zischl/ZAIR/README.md

# 🐭 ZAIR - 4WD Vacuum Micromouse

A custom 4WD vacuum micromouse built for the Sri Lanka IIT Micro Maze 3.0 competition (IEEE 16×16).

The PCB also serves as the robot's structural chassis, with cutouts for the drive wheels and a central aperture for a 1020 coreless motor suction fan.

<p align="center">
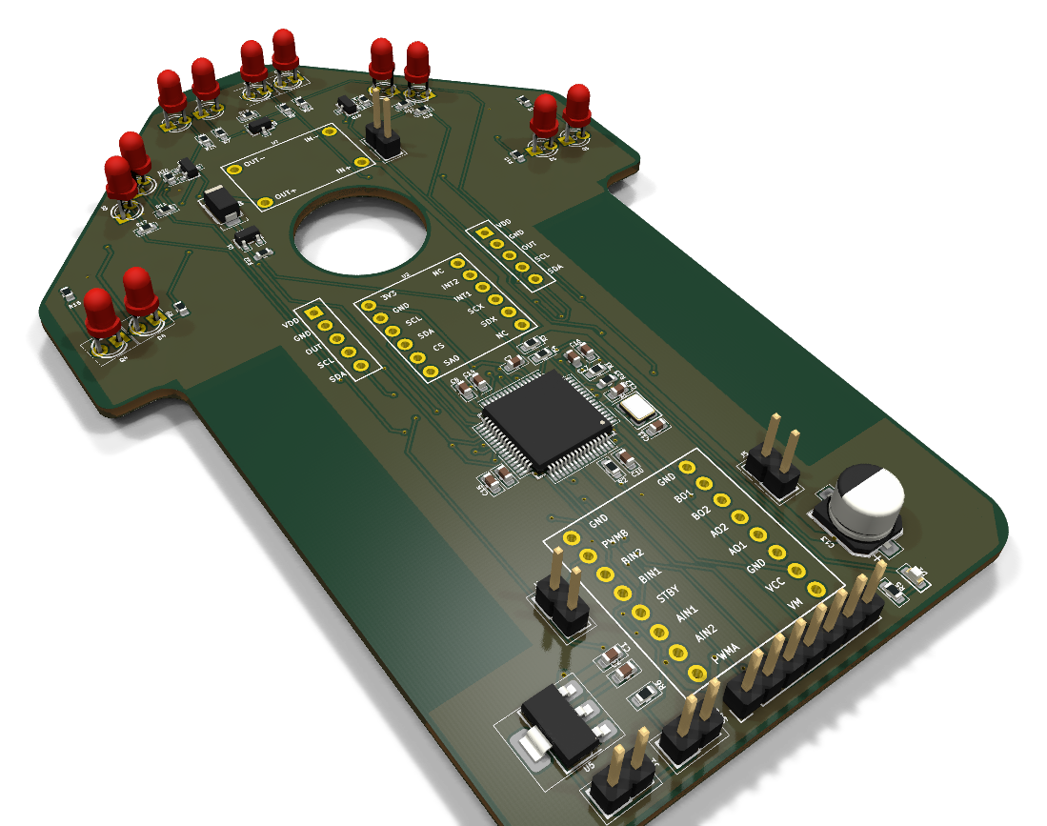
[picture p1: assets/pcb_render_isometric.png]
ZAIR PCB 3D Render
  
</p>

---

## 📸 PCB

| Top (Components) | Bottom |
| :---: | :---: |
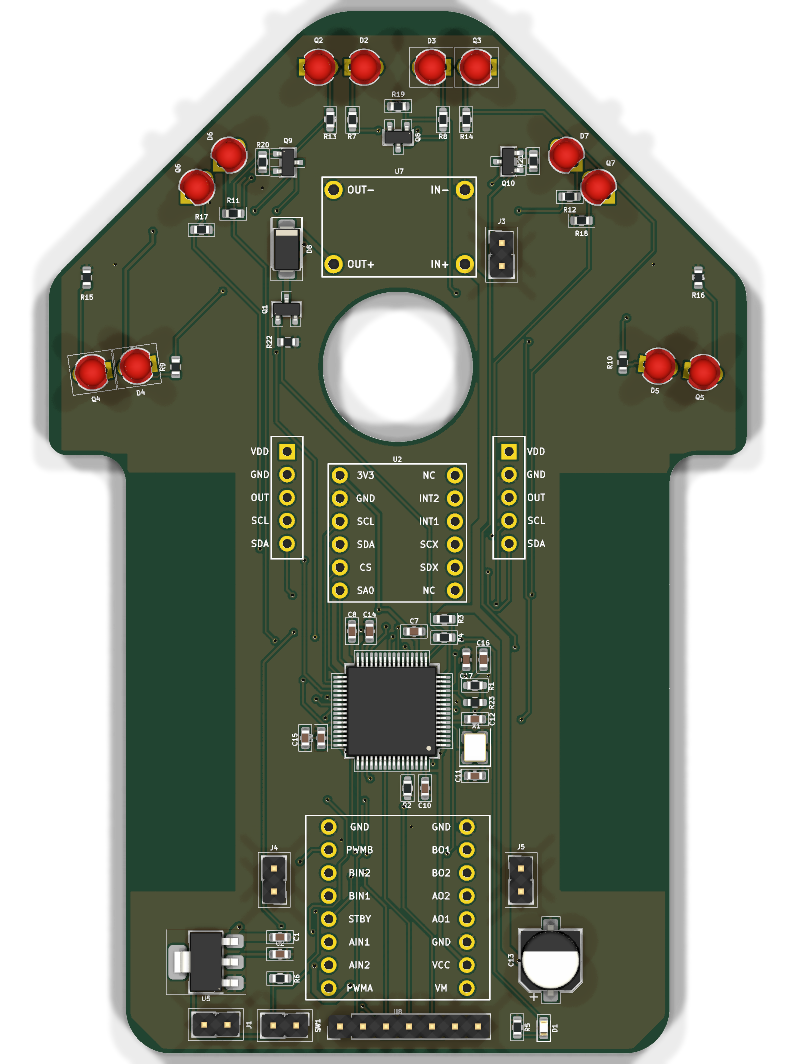
[picture p2: assets/pcb_render_top.png]
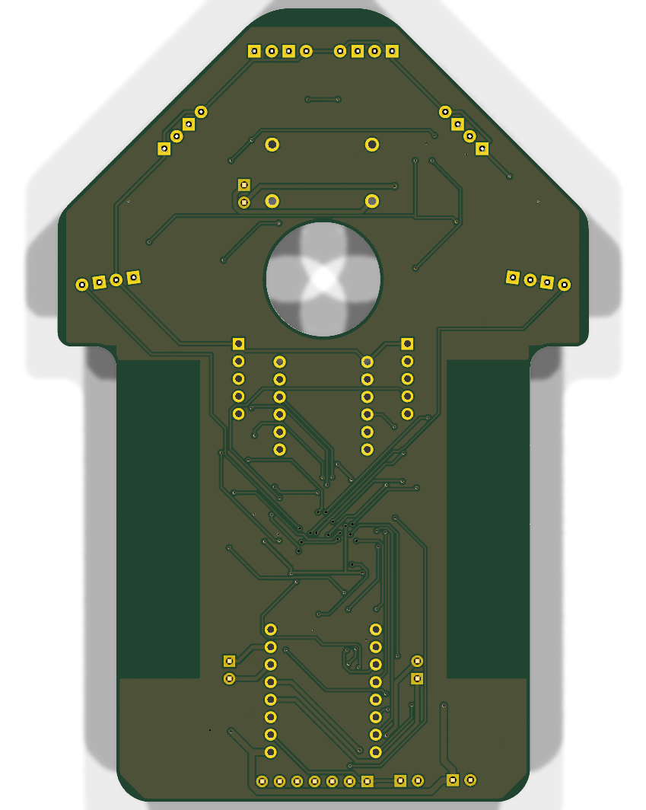
[picture p3: assets/pcb_render_bottom.png]
|  |  |

| Traces / Silkscreen | Outline & Cutouts |
| :---: | :---: |
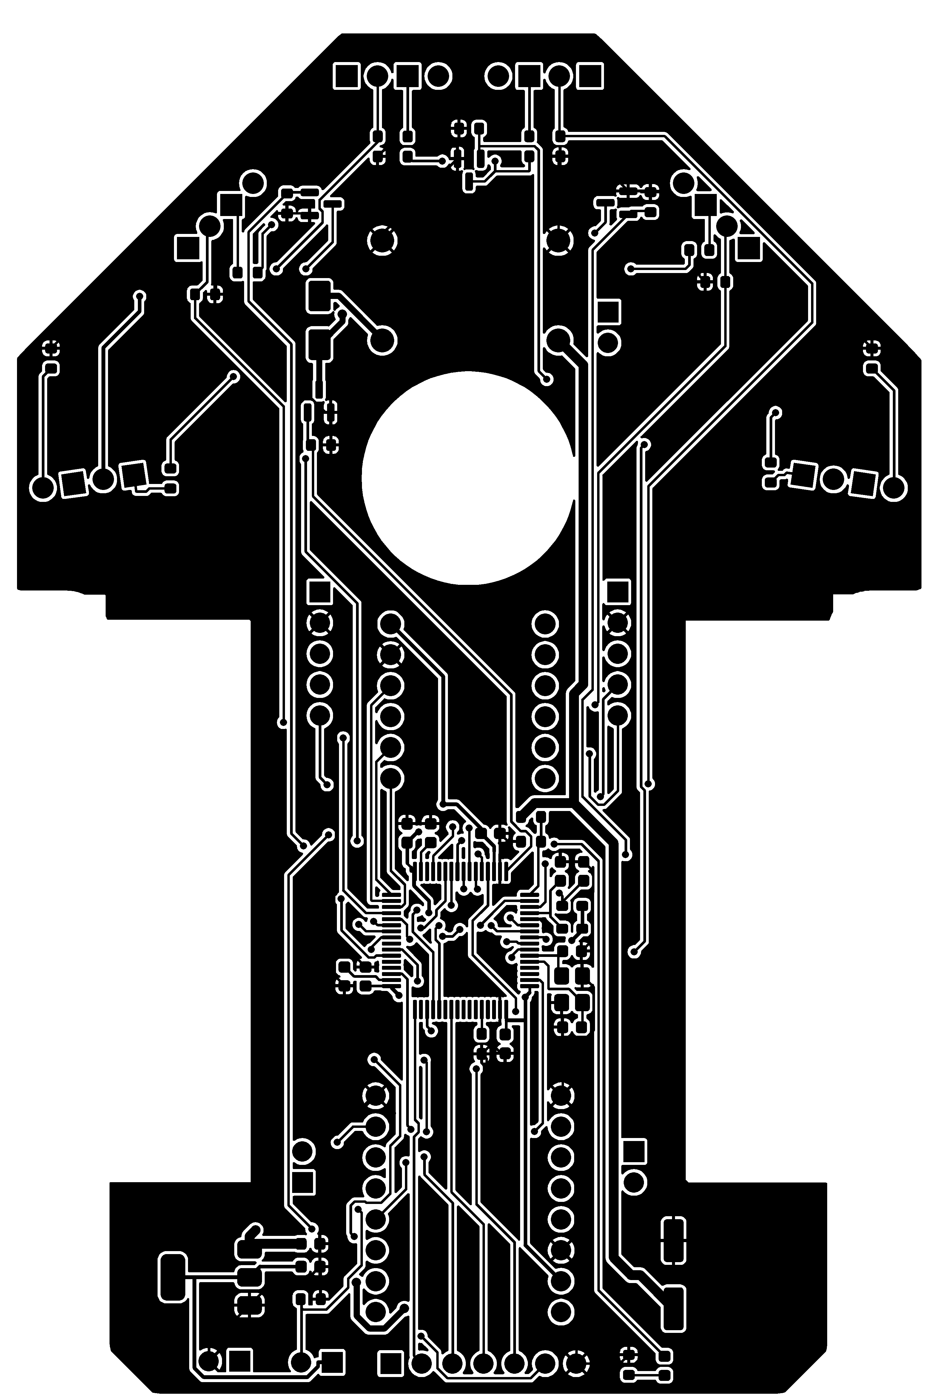
[picture p4: assets/pcb_top.png]
|  |  |

---

## ⚡ Hardware & Components

- **MCU:** STM32F405RGT6 (ARM Cortex-M4 @ 168MHz)
- **Drive Motors:** 2× Coreless 1718 motors
- **Motor Driver:** TB6612FNG breakout (red module)
- **Vacuum Fan:** Coreless 1020 motor switched by an AO3400 N-MOSFET + SS14 flyback diode
- **IMU:** LSM6DSV breakout (SPI2)
- **Encoders:** 2× MT6701 magnetic encoders (vertical 90° mounts, ABZ quadrature mode to TIM2/TIM3)
- **Sensors:** 4 active IR pairs (TEFT4300 phototransistors + SFH4545 850nm emitters, pulsed via AO3400 FETs)
- **Power:**
  - 2S LiPo (7.4V nominal)
  - MP2307 Mini360 buck converter stepped down to 3.5V for the vacuum motor
  - AMS1117-3.3 for 3.3V logic
- **Programming / Debug:** 7-pin header for SWD (`SWDIO`, `SWDCK`, `SWO`) and USART1 (`TX`, `RX`)

---

## 🛠️ PCB Specs & Files

Designed in KiCad.

- **Layers:** 2-layer FR4
- **Dimensions:** ~80mm × 115mm (1.6mm thickness, 1oz copper)
- **Silkscreen:** White

### Files

- **KiCad Project:** `hardware/schematic/ZAIR/`
- **Schematic PDF:** [`hardware/schematic/ZAIR/ZAIR_Schematic.pdf`](hardware/schematic/ZAIR/ZAIR_Schematic.pdf)
- **Gerbers:** [`hardware/schematic/ZAIR/gerbers/`](hardware/schematic/ZAIR/gerbers/)
- **BOM:** [`hardware/schematic/ZAIR/ZAIR.csv`](hardware/schematic/ZAIR/ZAIR.csv)

---

## ⚙️ Drivetrain CAD

Designed in Onshape. A 3-gear direct-drive setup where the central Coreless 1718 motor pinion meshes simultaneously with both geared wheels.

| 3-Gear Mesh | Drivetrain Assembly |
| :---: | :---: |
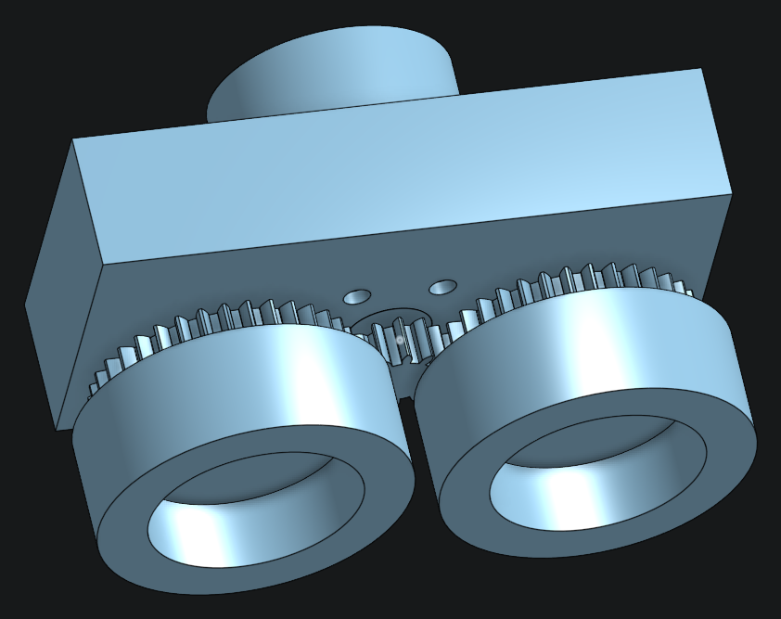
[picture p5: assets/drivetrain_mesh.png]
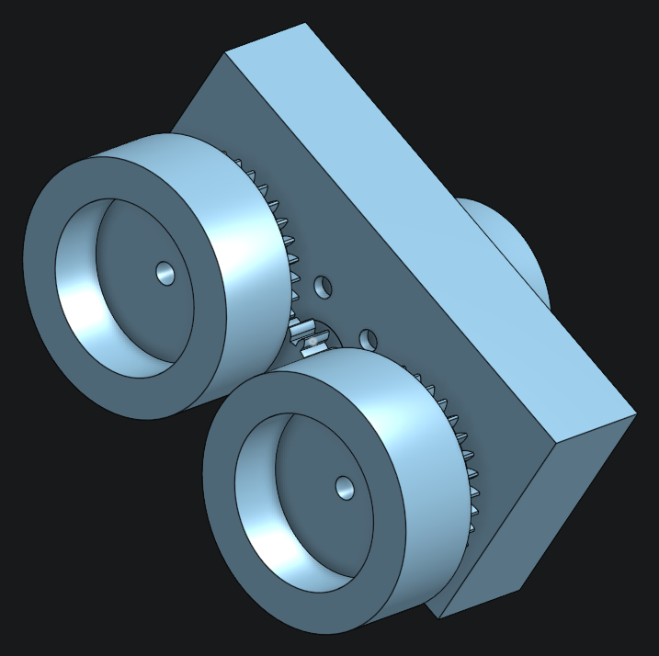
[picture p6: assets/drivetrain_assembly.png]
|  |  |

### STEP Models (`hardware/cad/`)

- **Motor:** Coreless 1718 ([`hardware/cad/motor_1718.step`](hardware/cad/motor_1718.step))
- **Wheel:** 22mm Geared Wheel ([`hardware/cad/geared_wheel.step`](hardware/cad/geared_wheel.step))
- **Mount:** Drivetrain motor mount bracket ([`hardware/cad/drivetrain_mount.step`](hardware/cad/drivetrain_mount.step))
