zischl/ZAIR/assets/pcb_bottom.png

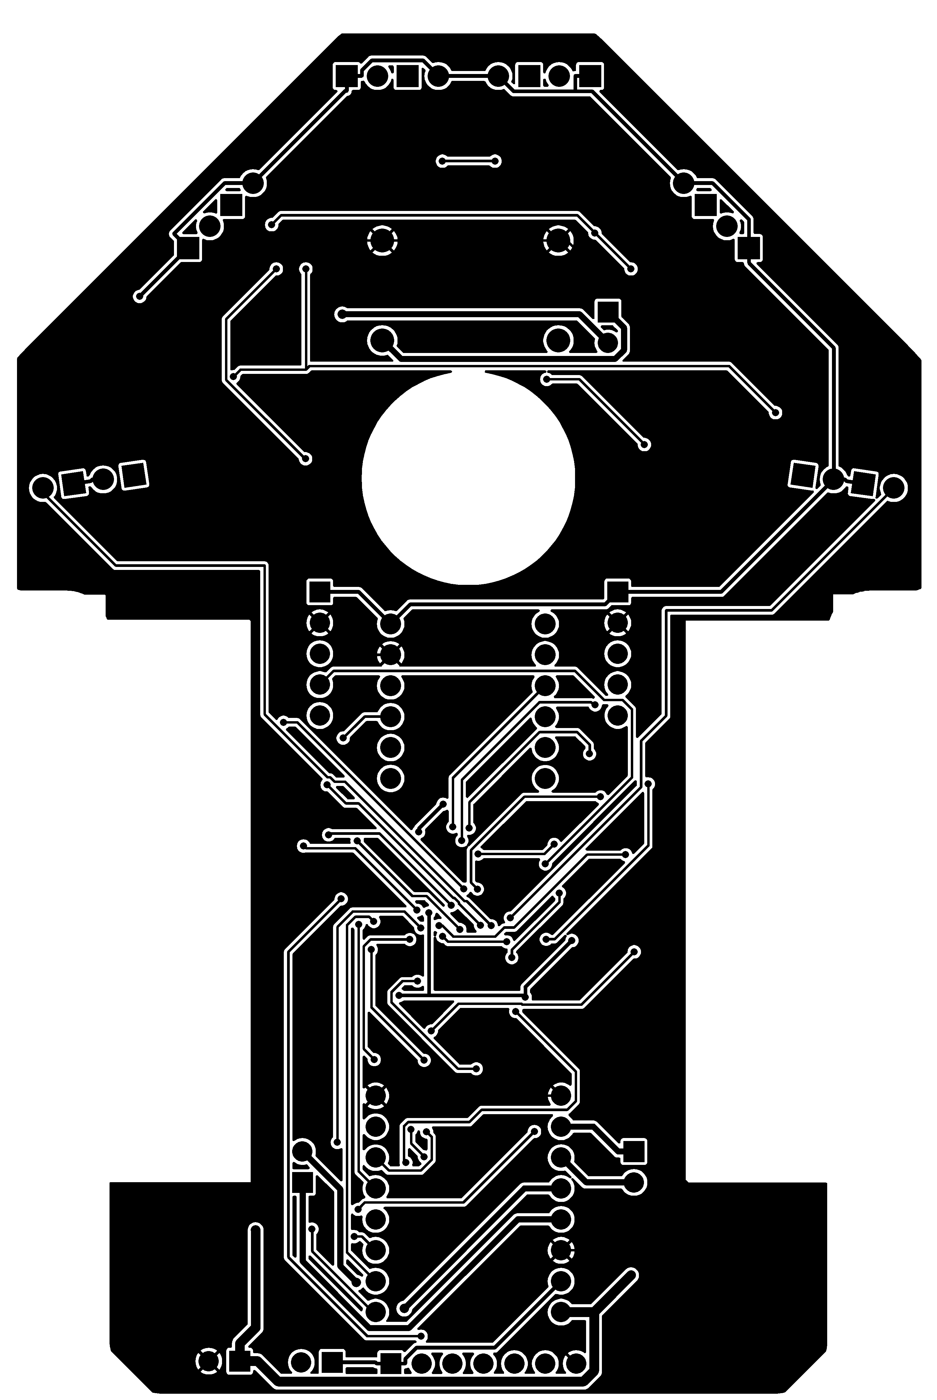
assets/pcb_bottom.png
