zischl/ZAIR/assets/pcb_chassis_overview.png

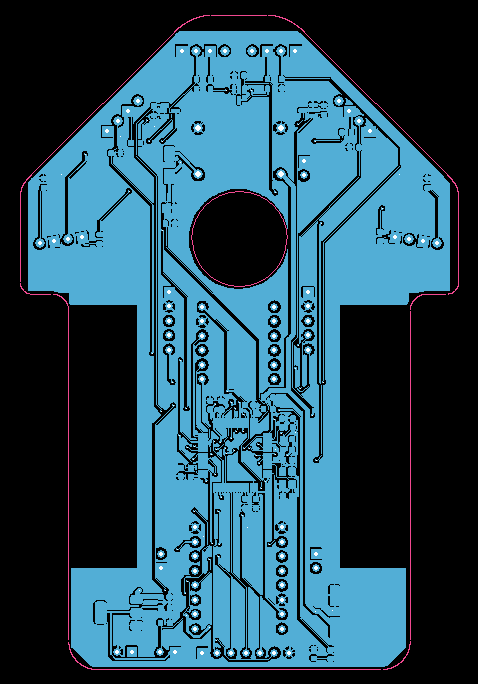
assets/pcb_chassis_overview.png
