zischl/ZAIR/hardware/schematic/ZAIR/ZAIR.csv

Reference | Qty | Value | DNP | Exclude from BOM | Exclude from Board | Exclude from Simulation | Exclude from Position Files | Footprint | Datasheet
C1,C2 | 2 | 10uF |  |  |  |  | ${EXCLUDE_FROM_POS_FILES} | Capacitor_SMD:C_0603_1608Metric
C7,C8,C9,C10,C16 | 5 | 100nF |  |  |  |  | ${EXCLUDE_FROM_POS_FILES} | Capacitor_SMD:C_0603_1608Metric
C11,C12 | 2 | 20pF |  |  |  |  | ${EXCLUDE_FROM_POS_FILES} | Capacitor_SMD:C_0603_1608Metric
C13 | 1 | 100uF |  |  |  |  | ${EXCLUDE_FROM_POS_FILES} | Capacitor_SMD:CP_Elec_6.3x5.4
C14,C15 | 2 | 2.2uF |  |  |  |  | ${EXCLUDE_FROM_POS_FILES} | Capacitor_SMD:C_0603_1608Metric
C17 | 1 | 1uF |  |  |  |  | ${EXCLUDE_FROM_POS_FILES} | Capacitor_SMD:C_0603_1608Metric
D1 | 1 | LED_BLUE |  |  |  |  | ${EXCLUDE_FROM_POS_FILES} | LED_SMD:LED_0603_1608Metric
D2 | 1 | SFH4545_FL |  |  |  |  | ${EXCLUDE_FROM_POS_FILES} | LED_THT:LED_D3.0mm
D3 | 1 | SFH4545_FR |  |  |  |  | ${EXCLUDE_FROM_POS_FILES} | LED_THT:LED_D3.0mm
D4 | 1 | SFH4545_L |  |  |  |  | ${EXCLUDE_FROM_POS_FILES} | LED_THT:LED_D3.0mm
D5 | 1 | SFH4545_R |  |  |  |  | ${EXCLUDE_FROM_POS_FILES} | LED_THT:LED_D3.0mm
D6 | 1 | SFH4545_DL |  |  |  |  | ${EXCLUDE_FROM_POS_FILES} | LED_THT:LED_D3.0mm
D7 | 1 | SFH4545_DR |  |  |  |  | ${EXCLUDE_FROM_POS_FILES} | LED_THT:LED_D3.0mm
D8 | 1 | SS14_FLYBACK |  |  |  |  | ${EXCLUDE_FROM_POS_FILES} | Diode_SMD:D_SMA
J1 | 1 | VBAT_IN |  |  |  |  | ${EXCLUDE_FROM_POS_FILES} | Connector_PinHeader_2.54mm:PinHeader_1x02_P2.54mm_Vertical
J3 | 1 | VAC_MOTOR |  |  |  |  | ${EXCLUDE_FROM_POS_FILES} | Connector_PinHeader_2.54mm:PinHeader_1x02_P2.54mm_Vertical
J4 | 1 | MOT_LEFT |  |  |  |  | ${EXCLUDE_FROM_POS_FILES} | Connector_PinHeader_2.54mm:PinHeader_1x02_P2.54mm_Vertical
J5 | 1 | MOT_RIGHT |  |  |  |  | ${EXCLUDE_FROM_POS_FILES} | Connector_PinHeader_2.54mm:PinHeader_1x02_P2.54mm_Vertical
J7 | 1 | SWD_UART_SWO |  |  |  |  | ${EXCLUDE_FROM_POS_FILES} | Connector_PinHeader_2.54mm:PinHeader_1x07_P2.54mm_Vertical
Q1 | 1 | AO3400_VAC |  |  |  |  | ${EXCLUDE_FROM_POS_FILES} | Package_TO_SOT_SMD:SOT-23
Q2 | 1 | TEFT4300_FL |  |  |  |  | ${EXCLUDE_FROM_POS_FILES} | LED_THT:LED_D3.0mm
Q3 | 1 | TEFT4300_FR |  |  |  |  | ${EXCLUDE_FROM_POS_FILES} | LED_THT:LED_D3.0mm
Q4 | 1 | TEFT4300_L |  |  |  |  | ${EXCLUDE_FROM_POS_FILES} | LED_THT:LED_D3.0mm
Q5 | 1 | TEFT4300_R |  |  |  |  | ${EXCLUDE_FROM_POS_FILES} | LED_THT:LED_D3.0mm
Q6 | 1 | TEFT4300_DL |  |  |  |  | ${EXCLUDE_FROM_POS_FILES} | LED_THT:LED_D3.0mm
Q7 | 1 | TEFT4300_DR |  |  |  |  | ${EXCLUDE_FROM_POS_FILES} | LED_THT:LED_D3.0mm
Q8 | 1 | AO3400_FRONT |  |  |  |  | ${EXCLUDE_FROM_POS_FILES} | Package_TO_SOT_SMD:SOT-23
Q9 | 1 | AO3400_SIDE |  |  |  |  | ${EXCLUDE_FROM_POS_FILES} | Package_TO_SOT_SMD:SOT-23
Q10 | 1 | AO3400_DIAG |  |  |  |  | ${EXCLUDE_FROM_POS_FILES} | Package_TO_SOT_SMD:SOT-23
R1,R2,R4,R6,R13,R14,R15,R16,R17,R18,R19,R20,R21,R22 | 14 | 10k |  |  |  |  | ${EXCLUDE_FROM_POS_FILES} | Resistor_SMD:R_0603_1608Metric
R3 | 1 | 22k |  |  |  |  | ${EXCLUDE_FROM_POS_FILES} | Resistor_SMD:R_0603_1608Metric
R5 | 1 | 330 |  |  |  |  | ${EXCLUDE_FROM_POS_FILES} | Resistor_SMD:R_0603_1608Metric
R7,R8,R9,R10,R11,R12 | 6 | 33 |  |  |  |  | ${EXCLUDE_FROM_POS_FILES} | Resistor_SMD:R_0603_1608Metric
R23 | 1 | 0R/10R |  |  |  |  | ${EXCLUDE_FROM_POS_FILES} | Resistor_SMD:R_0603_1608Metric
SW1 | 1 | USER_BTN |  |  |  |  | ${EXCLUDE_FROM_POS_FILES} | Connector_PinHeader_2.54mm:PinHeader_1x02_P2.54mm_Vertical
U1 | 1 | STM32F405RGT6 |  |  |  |  | ${EXCLUDE_FROM_POS_FILES} | Package_QFP:LQFP-64_10x10mm_P0.5mm
U2 | 1 | LSM6DSV-BREAKOUT |  |  |  |  | ${EXCLUDE_FROM_POS_FILES} | ZAIR:LSM6DSV_Breakout
U3 | 1 | MT6701-L-01355 |  |  |  |  | ${EXCLUDE_FROM_POS_FILES} | ZAIR:MT6701_Breakout
U4 | 1 | MT6701-R-01355 |  |  |  |  | ${EXCLUDE_FROM_POS_FILES} | ZAIR:MT6701_Breakout
U5 | 1 | AMS1117-3.3 |  |  |  |  | ${EXCLUDE_FROM_POS_FILES} | Package_TO_SOT_SMD:SOT-223-3_TabPin2
U7 | 1 | MP2307-MINI360-MODULE |  |  |  |  | ${EXCLUDE_FROM_POS_FILES} | ZAIR:MP2307_Mini360_Buck
U8 | 1 | TB6612FNG-BREAKOUT |  |  |  |  | ${EXCLUDE_FROM_POS_FILES} | ZAIR:TB6612FNG_Breakout_Red
X1 | 1 | 8MHz |  |  |  |  | ${EXCLUDE_FROM_POS_FILES} | Crystal:Crystal_SMD_3225-4Pin_3.2x2.5mm
