zischl/ZAIR/hardware/cad/geared_wheel.step

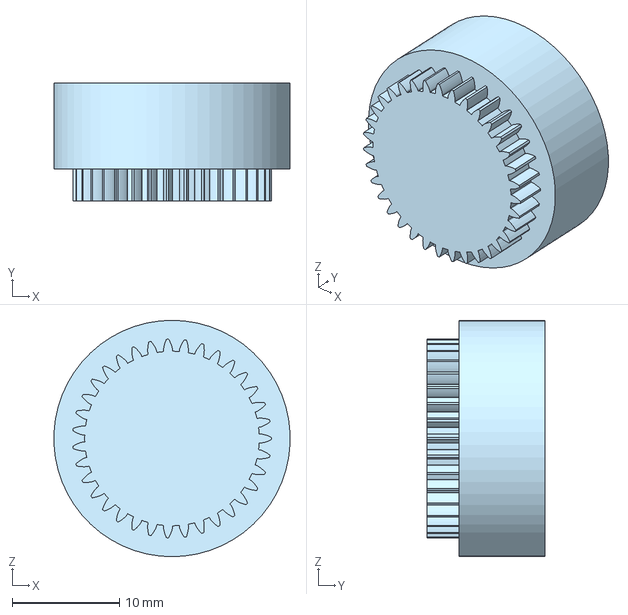
[picture p9: CAD file, 2026-10-17]
hardware/cad/geared_wheel.step
22.0 x 11.0 x 22.0 mm
