zischl/ZAIR/hardware/cad/drivetrain_mount.step

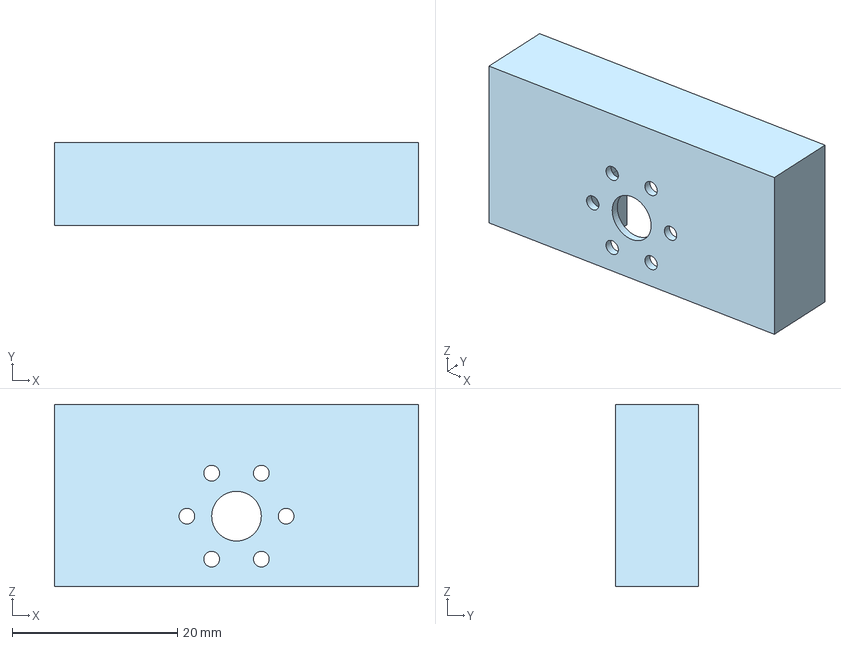
[picture p10: CAD file, 2026-10-17]
hardware/cad/drivetrain_mount.step
44.0 x 10.0 x 22.0 mm
