zischl/ZAIR/hardware/cad/motor_1718.step

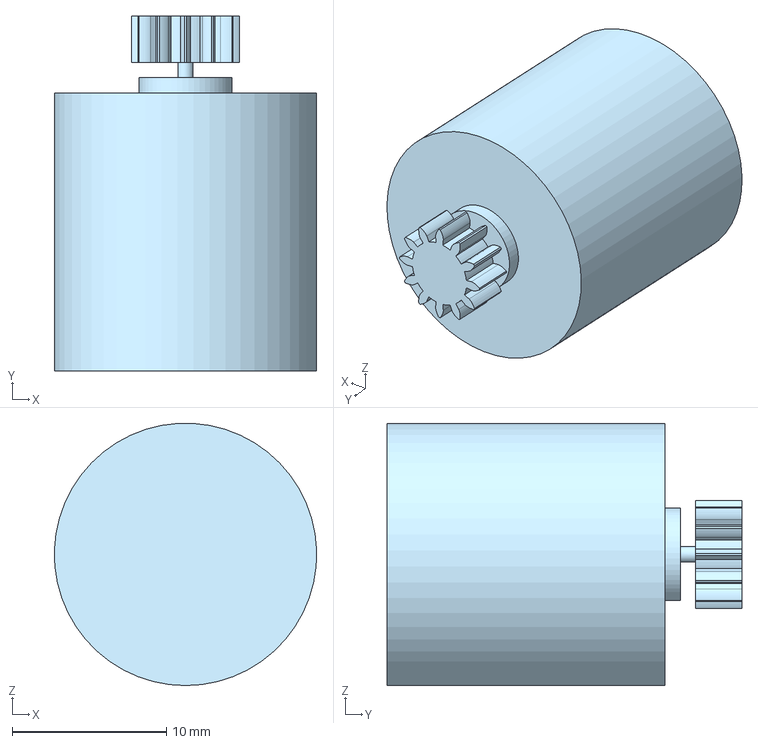
[picture p11: CAD file, 2026-10-17]
hardware/cad/motor_1718.step
17.0 x 23.0 x 17.0 mm
