zischl/ZAIR/hardware/schematic/ZAIR/ZAIR_Schematic.pdf

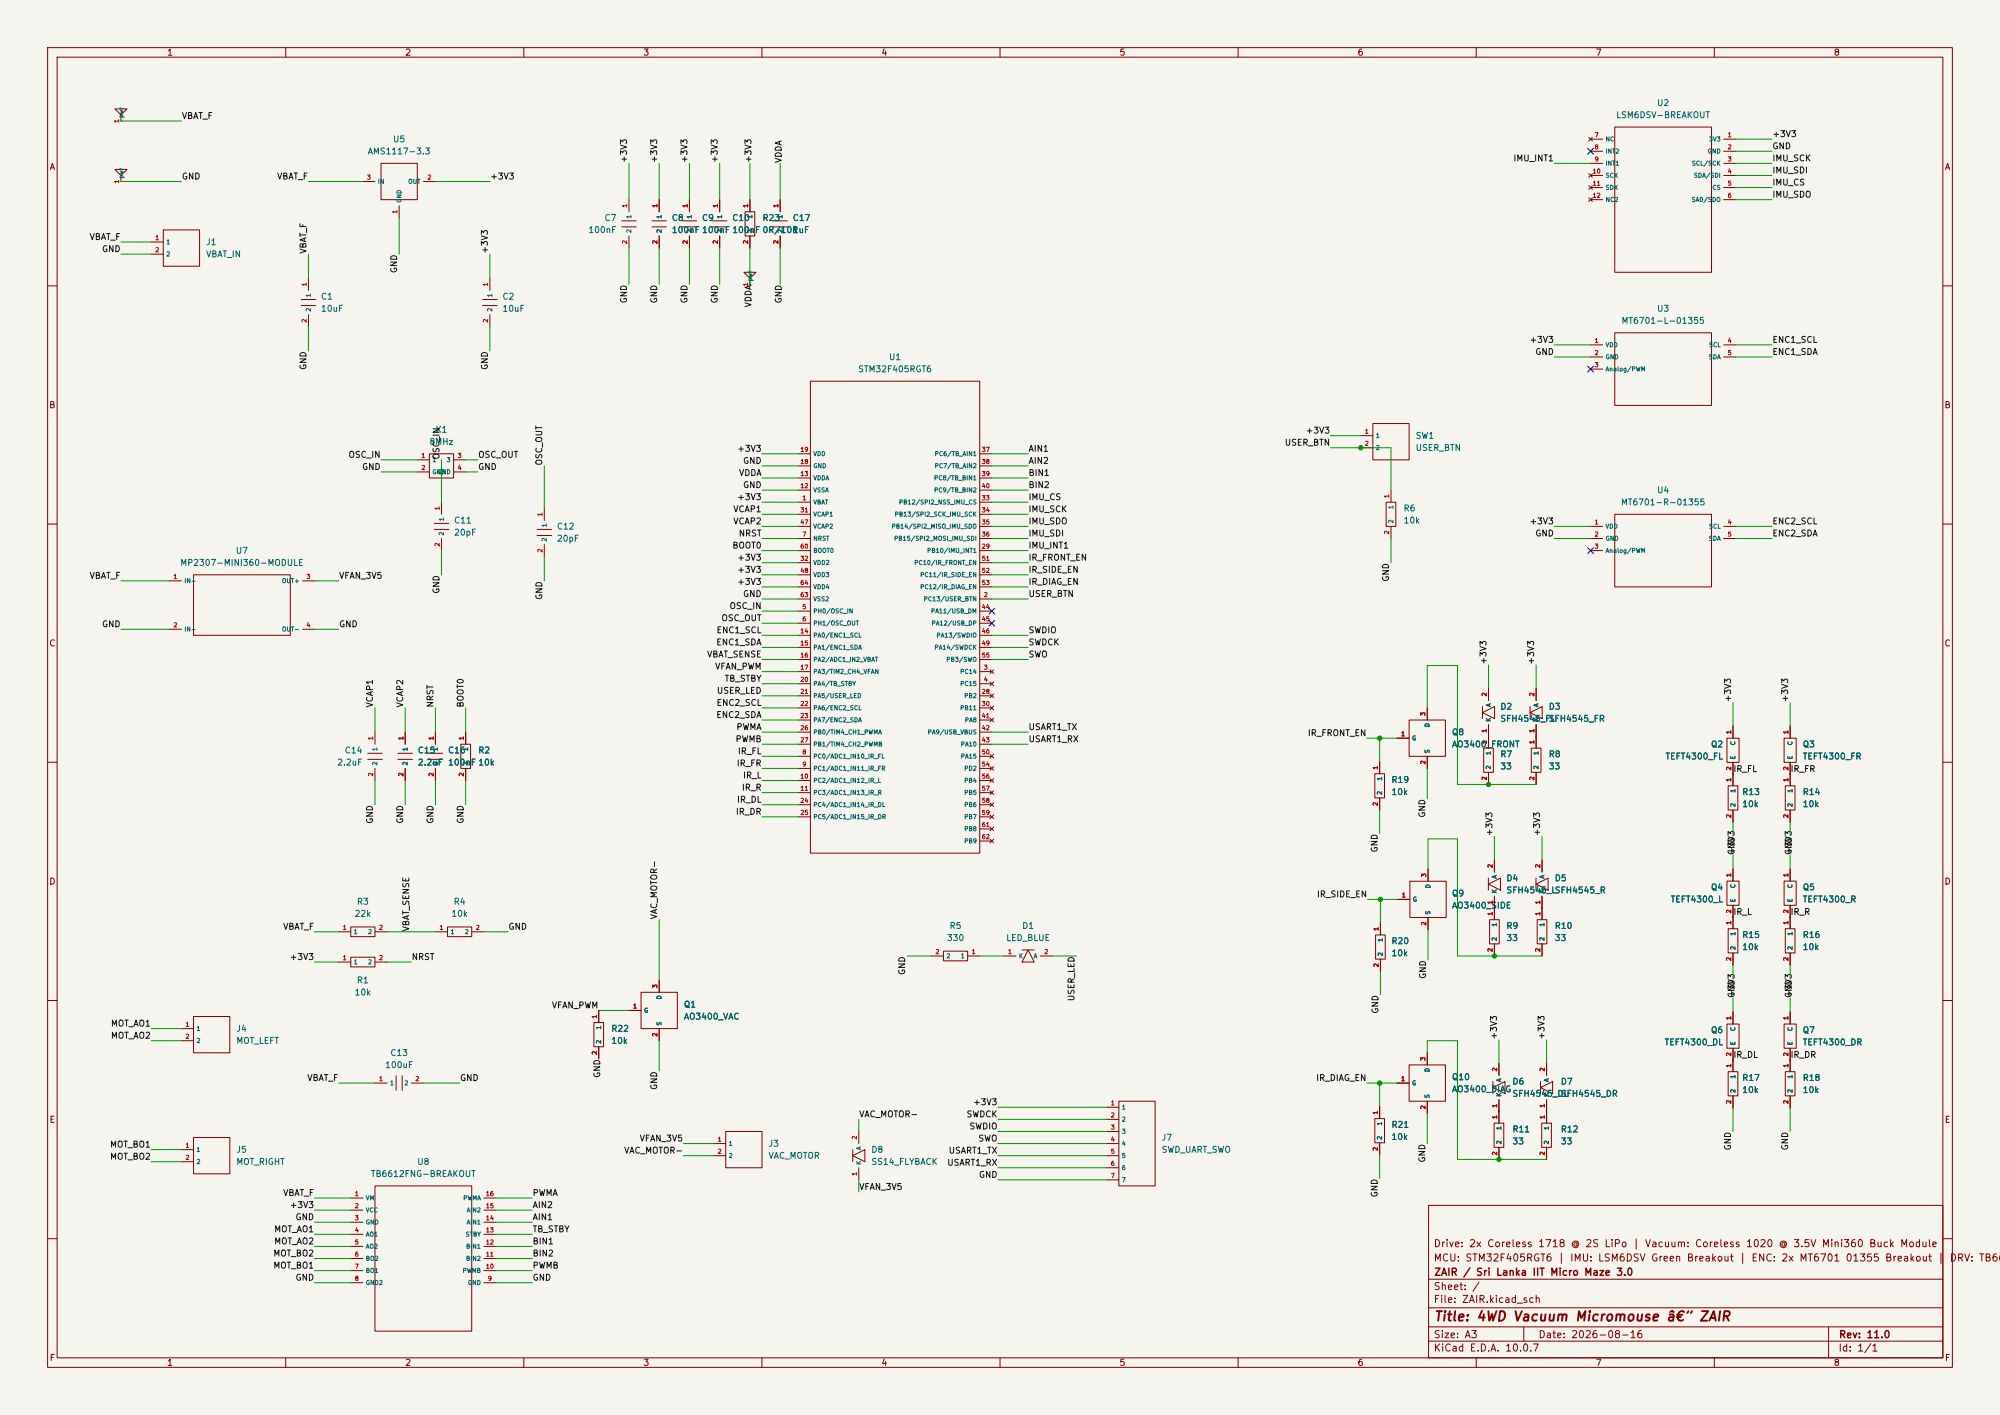
[picture p12: page 1]

Drive: 2x Coreless 1718 @ 2S LiPo | Vacuum: Coreless 1020 @ 3.5V Mini360 Buck Module
ZAIR / Sri Lanka IIT Micro Maze 3.0
Sheet: /
File: ZAIR.kicad_sch
Title: 4WD Vacuum Micromouse â€” ZAIR

Size: A3 | Rev: 11.0 | F Date: 2026-08-16
KiCad E.D.A. 10.0.7 | Id: 1/1
