zischl/ZAIR/hardware/schematic/ZAIR/ZAIR.kicad_pcb

## KiCad design hardware/schematic/ZAIR/ZAIR.kicad_pcb (2026-10-17)

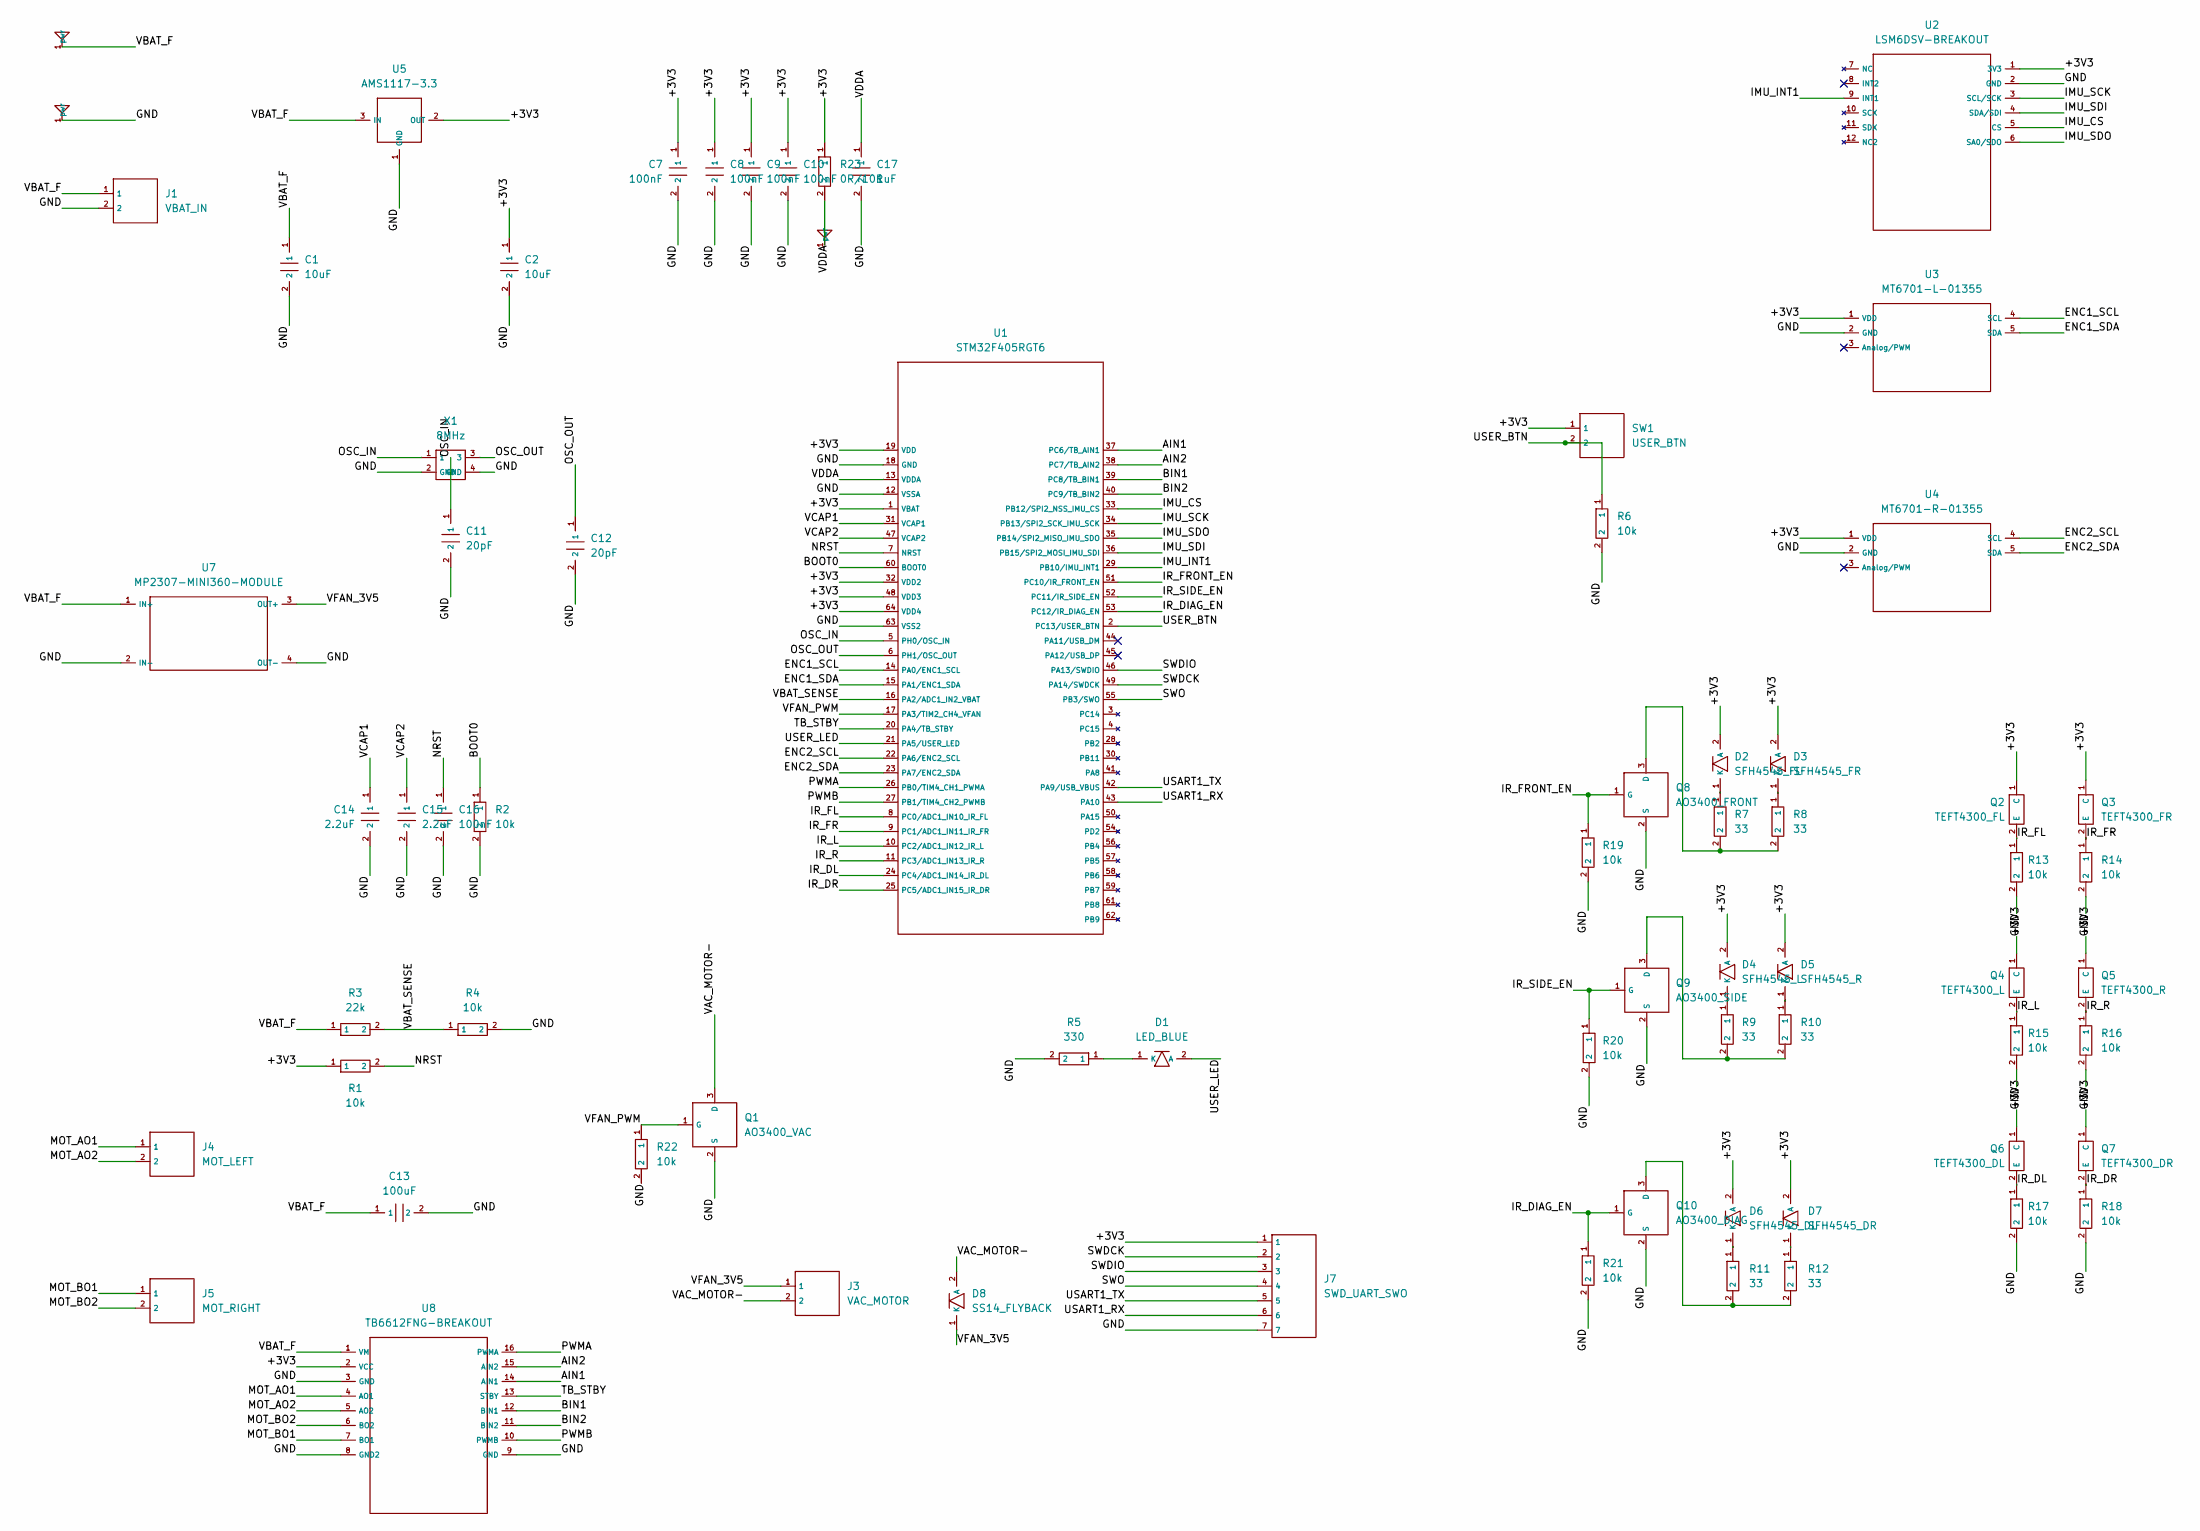
[picture p13: schematic ZAIR.kicad_sch, 4WD Vacuum Micromouse â€” ZAIR]

Parts:
C1, C2: 10uF; C_0603_1608Metric
C7, C8, C9, C10, C16: 100nF; C_0603_1608Metric
C11, C12: 20pF; C_0603_1608Metric
C13: 100uF; CP_Elec_6.3x5.4
C14, C15: 2.2uF; C_0603_1608Metric
C17: 1uF; C_0603_1608Metric
D1: LED_BLUE; LED_0603_1608Metric
D2: SFH4545_FL; LED_D3.0mm
D3: SFH4545_FR; LED_D3.0mm
D4: SFH4545_L; LED_D3.0mm
D5: SFH4545_R; LED_D3.0mm
D6: SFH4545_DL; LED_D3.0mm
D7: SFH4545_DR; LED_D3.0mm
D8: SS14_FLYBACK; D_SMA
J1: VBAT_IN; PinHeader_1x02_P2.54mm_Vertical
J3: VAC_MOTOR; PinHeader_1x02_P2.54mm_Vertical
J4: MOT_LEFT; PinHeader_1x02_P2.54mm_Vertical
J5: MOT_RIGHT; PinHeader_1x02_P2.54mm_Vertical
J7: SWD_UART_SWO; PinHeader_1x07_P2.54mm_Vertical
Q1: AO3400_VAC; SOT-23
Q2: TEFT4300_FL; LED_D3.0mm
Q3: TEFT4300_FR; LED_D3.0mm
Q4: TEFT4300_L; LED_D3.0mm
Q5: TEFT4300_R; LED_D3.0mm
Q6: TEFT4300_DL; LED_D3.0mm
Q7: TEFT4300_DR; LED_D3.0mm
Q8: AO3400_FRONT; SOT-23
Q9: AO3400_SIDE; SOT-23
Q10: AO3400_DIAG; SOT-23
R1, R2, R4, R6, R13, R14, R15, R16, R17, R18, R19, R20, R21, R22: 10k; R_0603_1608Metric
R3: 22k; R_0603_1608Metric
R5: 330; R_0603_1608Metric
R7, R8, R9, R10, R11, R12: 33; R_0603_1608Metric
R23: 0R/10R; R_0603_1608Metric
SW1: USER_BTN; PinHeader_1x02_P2.54mm_Vertical
U1: STM32F405RGT6; LQFP-64_10x10mm_P0.5mm
U2: LSM6DSV-BREAKOUT; LSM6DSV_Breakout
U3: MT6701-L-01355; MT6701_Breakout
U4: MT6701-R-01355; MT6701_Breakout
U5: AMS1117-3.3; SOT-223-3_TabPin2
U7: MP2307-MINI360-MODULE; MP2307_Mini360_Buck
U8: TB6612FNG-BREAKOUT; TB6612FNG_Breakout_Red
X1: 8MHz; Crystal_SMD_3225-4Pin_3.2x2.5mm

Connections:
/+3V3: C2.1, C7.1, C8.1, C9.1, C10.1, D2.2 (A), D3.2 (A), D4.2 (A), D5.2 (A), D6.2 (A), D7.2 (A), J7.1, Q2.1 (C), Q3.1 (C), Q4.1 (C), Q5.1 (C), Q6.1 (C), Q7.1 (C), R1.1, R23.1, SW1.1, U1.1 (VBAT), U1.19 (VDD), U1.32 (VDD2), U1.48 (VDD3), U1.64 (VDD4), U2.1 (3V3), U3.1 (VDD), U4.1 (VDD), U5.2 (OUT), U8.2 (VCC)
/AIN1: U1.37 (PC6/TB_AIN1), U8.14 (AIN1)
/AIN2: U1.38 (PC7/TB_AIN2), U8.15 (AIN2)
/BIN1: U1.39 (PC8/TB_BIN1), U8.12 (BIN1)
/BIN2: U1.40 (PC9/TB_BIN2), U8.11 (BIN2)
/BOOT0: R2.1, U1.60 (BOOT0)
/ENC1_SCL: U1.14 (PA0/ENC1_SCL), U3.4 (SCL)
/ENC1_SDA: U1.15 (PA1/ENC1_SDA), U3.5 (SDA)
/ENC2_SCL: U1.22 (PA6/ENC2_SCL), U4.4 (SCL)
/ENC2_SDA: U1.23 (PA7/ENC2_SDA), U4.5 (SDA)
/IMU_CS: U1.33 (PB12/SPI2_NSS_IMU_CS), U2.5 (CS)
/IMU_INT1: U1.29 (PB10/IMU_INT1), U2.9 (INT1)
/IMU_SCK: U1.34 (PB13/SPI2_SCK_IMU_SCK), U2.3 (SCL/SCK)
/IMU_SDI: U1.36 (PB15/SPI2_MOSI_IMU_SDI), U2.4 (SDA/SDI)
/IMU_SDO: U1.35 (PB14/SPI2_MISO_IMU_SDO), U2.6 (SA0/SDO)
/IR_DIAG_EN: Q10.1 (G), R21.1, U1.53 (PC12/IR_DIAG_EN)
/IR_DL: Q6.2 (E), R17.1, U1.24 (PC4/ADC1_IN14_IR_DL)
/IR_DR: Q7.2 (E), R18.1, U1.25 (PC5/ADC1_IN15_IR_DR)
/IR_FL: Q2.2 (E), R13.1, U1.8 (PC0/ADC1_IN10_IR_FL)
/IR_FR: Q3.2 (E), R14.1, U1.9 (PC1/ADC1_IN11_IR_FR)
/IR_FRONT_EN: Q8.1 (G), R19.1, U1.51 (PC10/IR_FRONT_EN)
/IR_L: Q4.2 (E), R15.1, U1.10 (PC2/ADC1_IN12_IR_L)
/IR_R: Q5.2 (E), R16.1, U1.11 (PC3/ADC1_IN13_IR_R)
/IR_SIDE_EN: Q9.1 (G), R20.1, U1.52 (PC11/IR_SIDE_EN)
/MOT_AO1: J4.1, U8.4 (AO1)
/MOT_AO2: J4.2, U8.5 (AO2)
/MOT_BO1: J5.1, U8.7 (BO1)
/MOT_BO2: J5.2, U8.6 (BO2)
/NRST: C16.1, R1.2, U1.7 (NRST)
/OSC_IN: C11.1, U1.5 (PH0/OSC_IN), X1.1
/OSC_OUT: C12.1, U1.6 (PH1/OSC_OUT), X1.3
/PWMA: U1.26 (PB0/TIM4_CH1_PWMA), U8.16 (PWMA)
/PWMB: U1.27 (PB1/TIM4_CH2_PWMB), U8.10 (PWMB)
/SWDCK: J7.2, U1.49 (PA14/SWDCK)
/SWDIO: J7.3, U1.46 (PA13/SWDIO)
/SWO: J7.4, U1.55 (PB3/SWO)
/TB_STBY: U1.20 (PA4/TB_STBY), U8.13 (STBY)
/USART1_RX: J7.6, U1.43 (PA10)
/USART1_TX: J7.5, U1.42 (PA9/USB_VBUS)
/USER_BTN: R6.1, SW1.2, U1.2 (PC13/USER_BTN)
/USER_LED: D1.2 (A), U1.21 (PA5/USER_LED)
/VAC_MOTOR-: D8.2 (A), J3.2, Q1.3 (D)
/VBAT_SENSE: R3.2, R4.1, U1.16 (PA2/ADC1_IN2_VBAT)
/VCAP1: C14.1, U1.31 (VCAP1)
/VCAP2: C15.1, U1.47 (VCAP2)
/VFAN_3V5: D8.1 (K), J3.1, U7.3 (OUT+)
/VFAN_PWM: Q1.1 (G), R22.1, U1.17 (PA3/TIM2_CH4_VFAN)
unnamed: D1.1 (K), R5.1
unnamed: D2.1 (K), R7.1
unnamed: D3.1 (K), R8.1
unnamed: D4.1 (K), R9.1
unnamed: D5.1 (K), R10.1
unnamed: D6.1 (K), R11.1
unnamed: D7.1 (K), R12.1
unnamed: Q8.3 (D), R7.2, R8.2
unnamed: Q9.3 (D), R9.2, R10.2
unnamed: Q10.3 (D), R11.2, R12.2

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
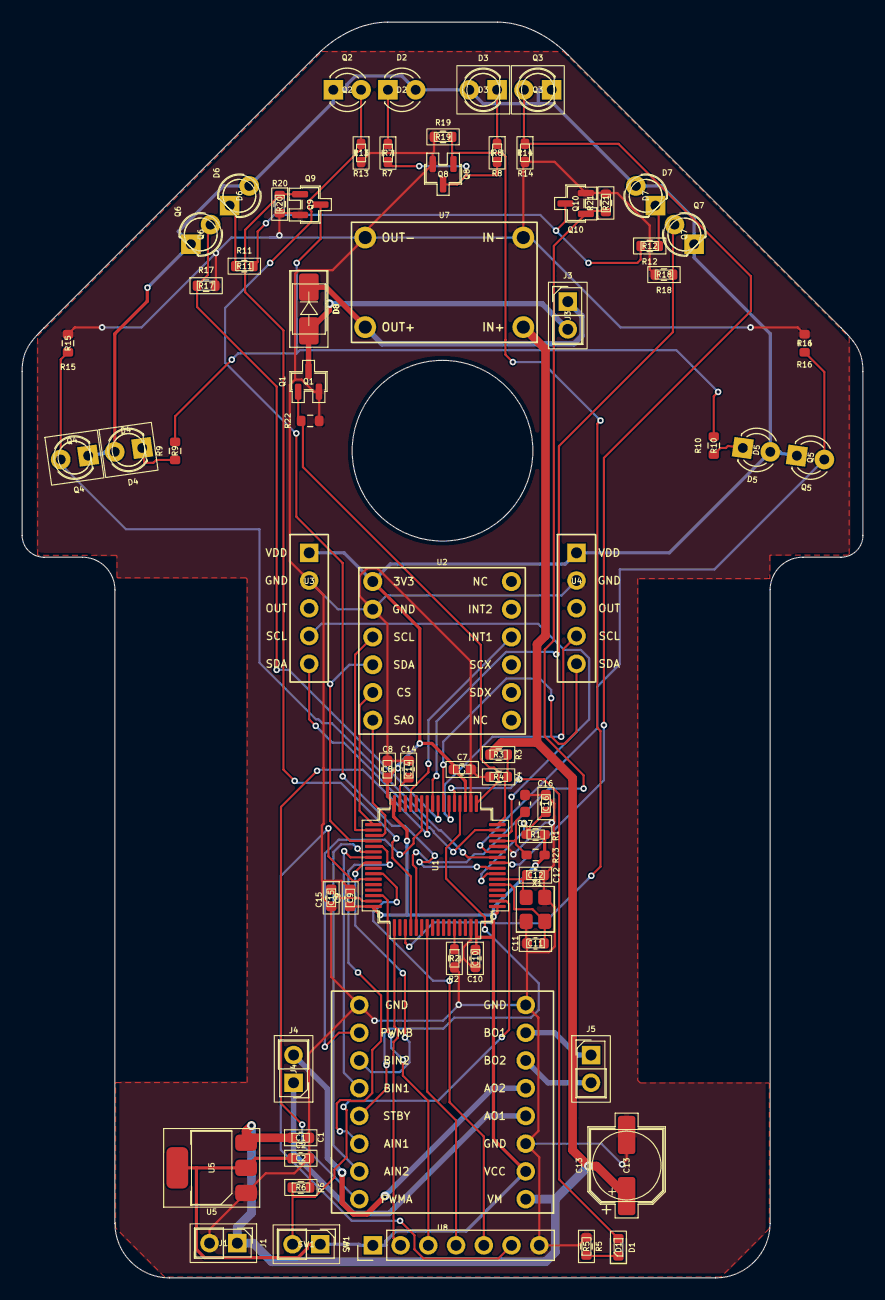
[picture p14: board ZAIR.kicad_pcb from above]

Board: 2 copper layers, 77.0 x 115.0 mm, 68 parts (0 on the bottom side), 60 nets.
