zischl/ZAIR/(commit log)

2026-10-17 - ZAIR MicroMouse build init.
    This commit includes the pcb created for the build.
    [ZAIR-B_Cu.gbr, ZAIR-B_Mask.gbr, ZAIR-B_Paste.gbr, ZAIR-B_Silkscreen.gbr, ZAIR-Edge_Cuts.gbr, ZAIR-F_Cu.gbr, ZAIR-F_Mask.gbr, ZAIR-F_Paste.gbr]
2026-10-17 - Add initial project README
    - Introduce the ZAIR 4WD Vacuum Micromouse project.
    - Provide an overview of the robot's design, including its PCB-as-chassis concept.
    - Include various PCB renders and detailed views (top, bottom, traces, outline).
    - List key hardware components and their specifications.
    - Detail PCB specifications and provide links to relevant design files (KiCad project, schematic, gerbers, BOM).
2026-10-17 - Add drivetrain CAD models and documentation
    - Add STEP models for the Coreless 1718 motor, geared wheel, and drivetrain mount.
    - Update README with a new "⚙️ Drivetrain CAD" section, including design overview, images, and links to STEP files.
    - Include new image assets (`drivetrain_mesh.png`, `drivetrain_assembly.png`) for drivetrain visualization.
    - Refine `.gitignore` to specifically exclude KiCad 3D board exports, enabling tracking of other CAD files.
    - Apply minor KiCad project file updates (thermal relief settings, default net colors/assignments).
    [drivetrain_mount.step, geared_wheel.step, motor_1718.step]
